korneliuszo/pcmciahost/(list of files, drawings)

Other design files:
sch/arduino-wirewrap/arduino-wirewrap.dsn
