korneliuszo/pcmciahost/sch/arduino-wirewrap/arduino-wirewrap.sch

## KiCad design sch/arduino-wirewrap/arduino-wirewrap.sch (2021-01-17)

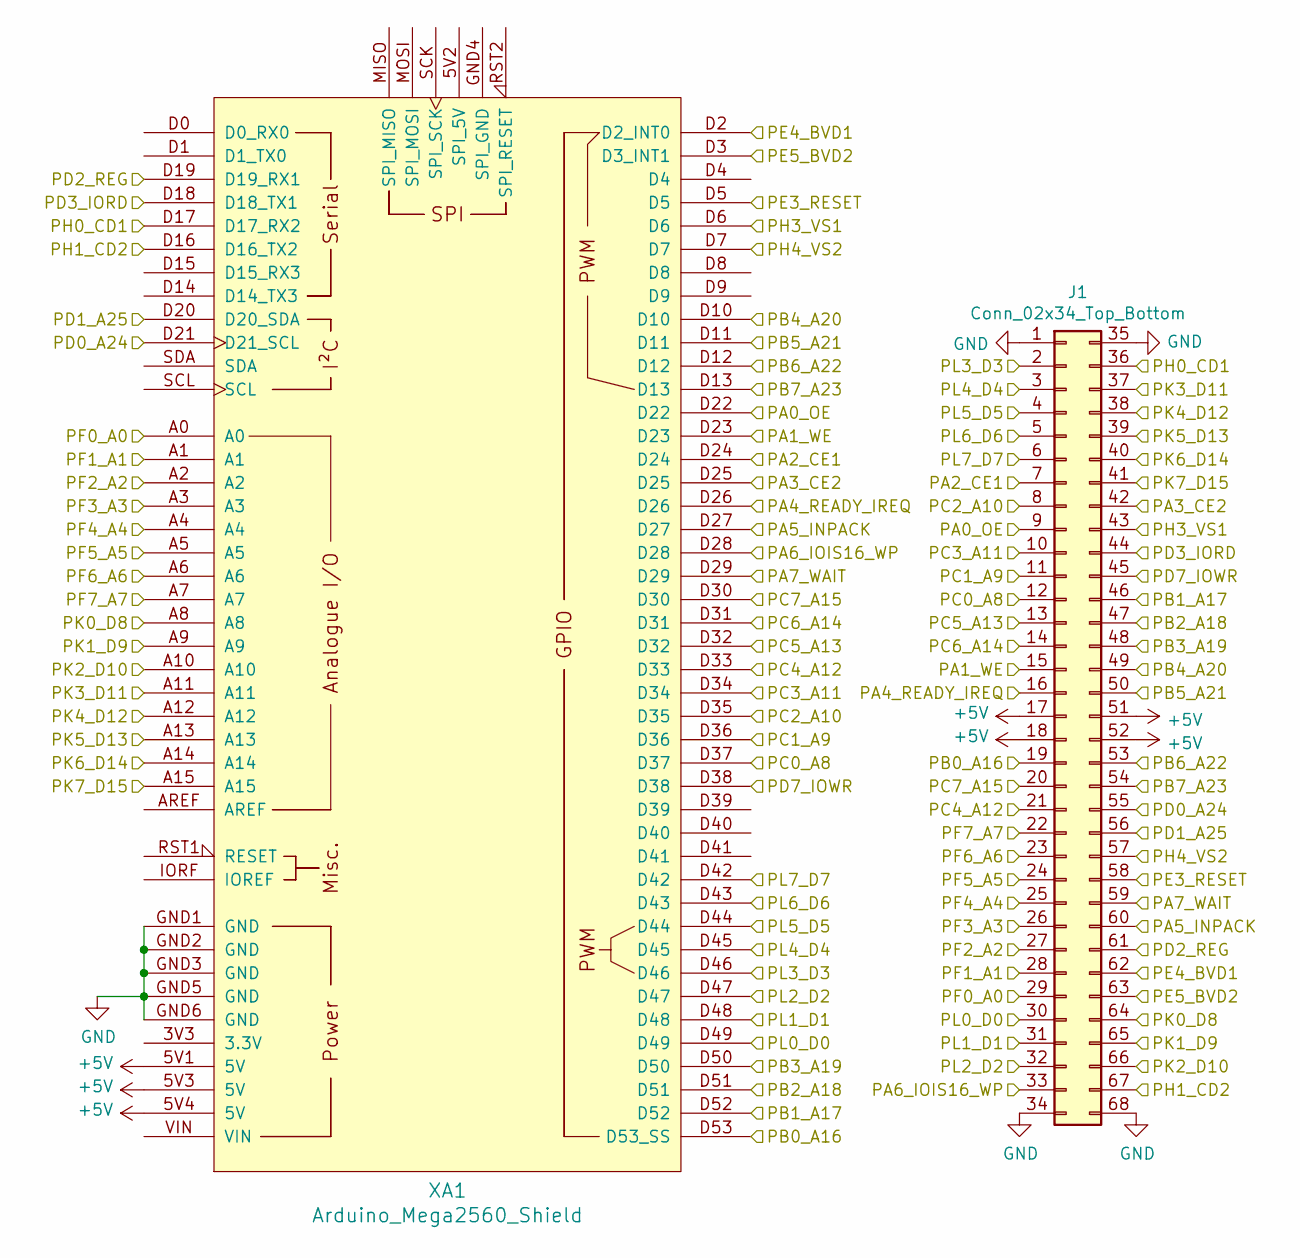
[picture p1: schematic arduino-wirewrap.sch]

Parts:
J1: Conn_02x34_Top_Bottom; 10118309
XA1: Arduino_Mega2560_Shield

Connections:
+5V: J1.17, J1.18, J1.51, J1.52, XA1.5V1 (5V), XA1.5V3 (5V), XA1.5V4 (5V)
GND: J1.1, J1.34, J1.35, J1.68, XA1.GND1 (GND), XA1.GND2 (GND), XA1.GND3 (GND), XA1.GND5 (GND), XA1.GND6 (GND)
PA0_OE: J1.9, XA1.D22
PA1_WE: J1.15, XA1.D23
PA2_CE1: J1.7, XA1.D24
PA3_CE2: J1.42, XA1.D25
PA4_READY_IREQ: J1.16, XA1.D26
PA5_INPACK: J1.60, XA1.D27
PA6_IOIS16_WP: J1.33, XA1.D28
PA7_WAIT: J1.59, XA1.D29
PB0_A16: J1.19, XA1.D53 (D53_SS)
PB1_A17: J1.46, XA1.D52
PB2_A18: J1.47, XA1.D51
PB3_A19: J1.48, XA1.D50
PB4_A20: J1.49, XA1.D10
PB5_A21: J1.50, XA1.D11
PB6_A22: J1.53, XA1.D12
PB7_A23: J1.54, XA1.D13
PC0_A8: J1.12, XA1.D37
PC1_A9: J1.11, XA1.D36
PC2_A10: J1.8, XA1.D35
PC3_A11: J1.10, XA1.D34
PC4_A12: J1.21, XA1.D33
PC5_A13: J1.13, XA1.D32
PC6_A14: J1.14, XA1.D31
PC7_A15: J1.20, XA1.D30
PD0_A24: J1.55, XA1.D21 (D21_SCL)
PD1_A25: J1.56, XA1.D20 (D20_SDA)
PD2_REG: J1.61, XA1.D19 (D19_RX1)
PD3_IORD: J1.44, XA1.D18 (D18_TX1)
PD7_IOWR: J1.45, XA1.D38
PE3_RESET: J1.58, XA1.D5
PE4_BVD1: J1.62, XA1.D2 (D2_INT0)
PE5_BVD2: J1.63, XA1.D3 (D3_INT1)
PF0_A0: J1.29, XA1.A0
PF1_A1: J1.28, XA1.A1
PF2_A2: J1.27, XA1.A2
PF3_A3: J1.26, XA1.A3
PF4_A4: J1.25, XA1.A4
PF5_A5: J1.24, XA1.A5
PF6_A6: J1.23, XA1.A6
PF7_A7: J1.22, XA1.A7
PH0_CD1: J1.36, XA1.D17 (D17_RX2)
PH1_CD2: J1.67, XA1.D16 (D16_TX2)
PH3_VS1: J1.43, XA1.D6
PH4_VS2: J1.57, XA1.D7
PK0_D8: J1.64, XA1.A8
PK1_D9: J1.65, XA1.A9
PK2_D10: J1.66, XA1.A10
PK3_D11: J1.37, XA1.A11
PK4_D12: J1.38, XA1.A12
PK5_D13: J1.39, XA1.A13
PK6_D14: J1.40, XA1.A14
PK7_D15: J1.41, XA1.A15
PL0_D0: J1.30, XA1.D49
PL1_D1: J1.31, XA1.D48
PL2_D2: J1.32, XA1.D47
PL3_D3: J1.2, XA1.D46
PL4_D4: J1.3, XA1.D45
PL5_D5: J1.4, XA1.D44
PL6_D6: J1.5, XA1.D43
PL7_D7: J1.6, XA1.D42
