korneliuszo/pcmciahost/(commit log)

2021-01-17 Add initial board version
    [arduino-wirewrap.dsn, arduino-wirewrap.kicad_pcb, arduino-wirewrap.sch]
2021-01-17 Connect VPP to 5V as standard says
    [arduino-wirewrap.kicad_pcb, arduino-wirewrap.sch]
2021-01-19 Relayout board as pcmcia connectior will clash with usb connector
    [arduino-wirewrap.dsn, arduino-wirewrap.kicad_pcb]
2021-01-19 Add gerber files for V1.0 board
    [arduino-wirewrap-B_Cu.gbr, arduino-wirewrap-B_Mask.gbr, arduino-wirewrap-B_SilkS.gbr, arduino-wirewrap-Edge_Cuts.gbr, arduino-wirewrap-F_Cu.gbr, arduino-wirewrap-F_Mask.gbr, arduino-wirewrap-F_SilkS.gbr, arduino-wirewrap-NPTH.drl]
2021-04-09 Device info is used in other tuples
2021-04-15 Add computer readable parsed struct & small corrections
    [printattr.py]
2021-04-15 Reset logic is not iverted
    [pcmcia_host.c]
2021-04-16 Fix properties and start initializing card
    [idehost.py]
